trchen1033/VoronMods/btt_tft43_mount/README.md

This is a front skirt 45 deg swival mount for BTT TFT43 touchscreen.

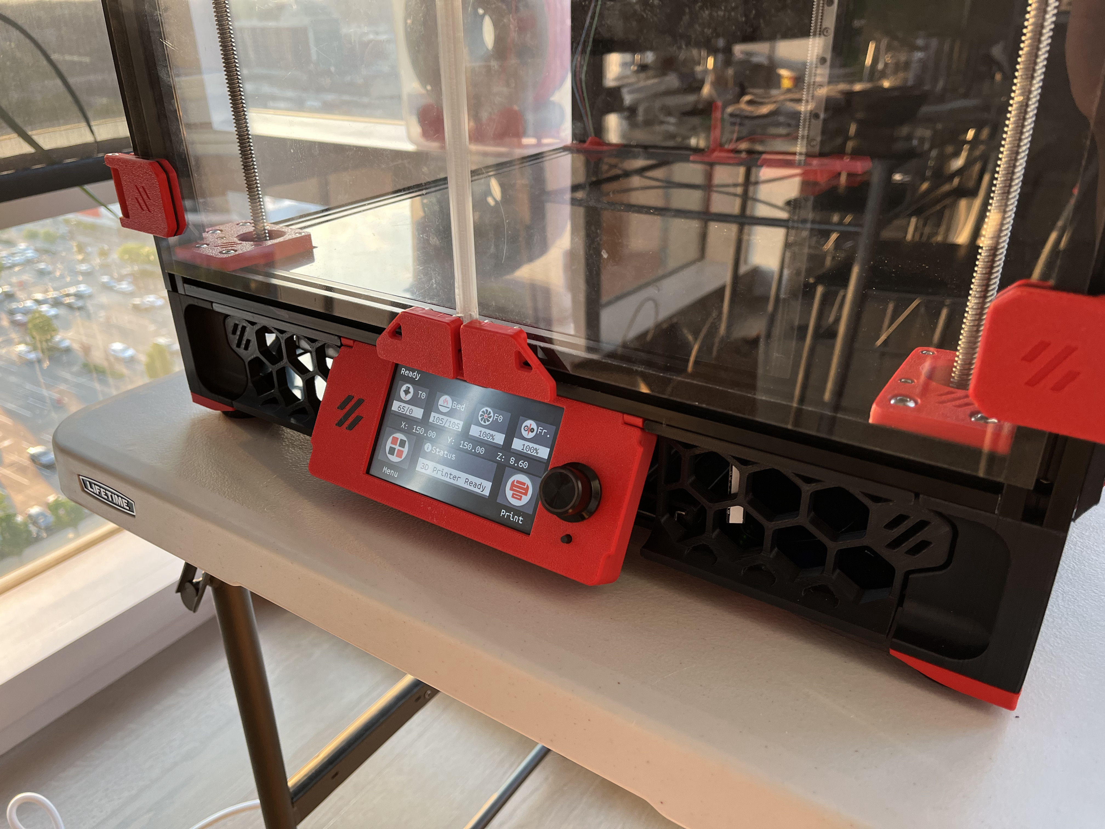
[picture p3: btt_tft43_mount/btt tft43 mount.jpg]
Install Photo


## BOM

- BTT TFT43 touchscreen * 1
- M5x10 BHCS * 1
- M3x8 SHCS * 4
- M3x12 SHCS * 4
- M3x40 SHCS * 1
- M3x5x4 heat-set insert * 7
- 2x25mm shaft (may use 1.75mm filament instead) * 2
- M3 T-nut or hammerhead nut * 2
- M5 T-nut or hammerhead nut * 1
- Narrower front skirt pieces. For 350mm printer uses 300mm skirts,
  300mm printer uses 250mm skirts. You'll have to shrink skirts
  by 25mm yourself if you have a 250mm printer.

## Known Issues

- Only supports touchscreen mode. The EXP1/EXP2 connector for
mini12864 emulation mode is blocked by the swival position block.

- Due to lack of major part dimensions on BTT's CAD file, it is
not designed for proper tolerance. It is a snug fit on mine, but
might not fit yours.

## Installation

1. Install the logo and 4 * M3 heat set insert into the front case.

2. Install 2 * M3 heat set insert into 2 holes in the center of the rear case.

3. Connect the hinges to the front case using the 2mm shafts.
   1.75mm filaments may be used in place of the shafts if not available,
   prefers CF/GF reinforced filaments.

4. Mount the hinges under the extrusion using M3x8 SHCS and T-nut * 2.

5. Sandwich BTT TFT43 between the front case and rear case,
   fasten with M3x12 SHCS * 4.

6. Install M3 heat set insert to the rear brace. This is only used to
   retain the M3x40 SHCS. 

7. Install the rear brace to rear case with M3x8 SHCS * 2.

8. Install the swival position block onto back of the extrusion,
   in between the two arms of the rear brace using M5x10 SHCS and T-nut.

9. Install the M3x40 SHCS to the rear brace, tighten against the
   heat set insert. It does not clamp the arms in any way.
