trchen1033/VoronMods/btt_tft43_mount/src/front_skirt_a_250.stl

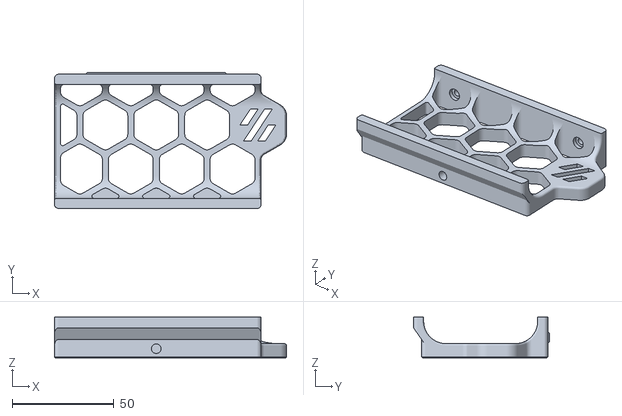
[picture p4: CAD file, 2022-05-22]
btt_tft43_mount/src/front_skirt_a_250.stl
114.0 x 66.8 x 20.0
