trchen1033/VoronMods/btt_tft43_mount/STLs/btt tft43 mount rear_brace.stl

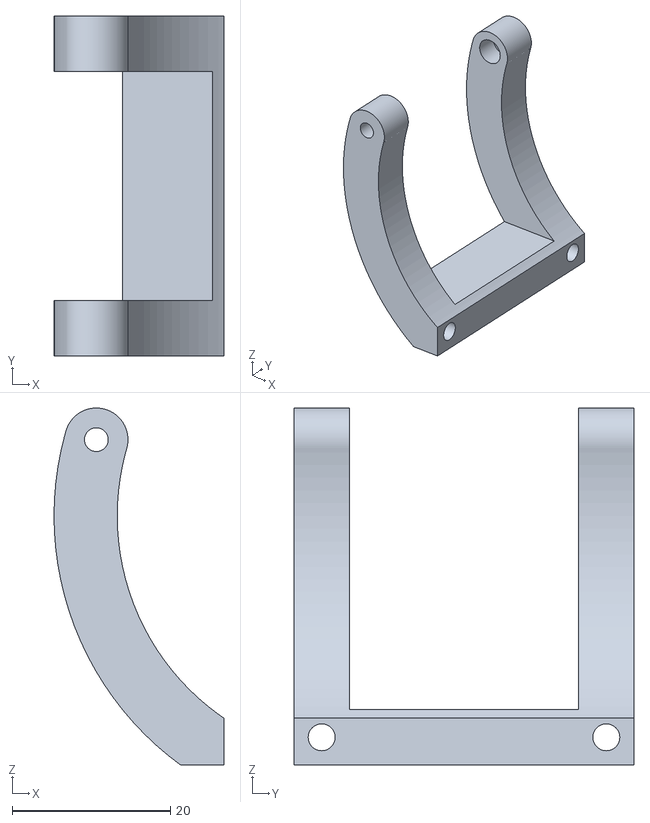
[picture p5: CAD file, 2022-05-22]
btt_tft43_mount/STLs/btt tft43 mount rear_brace.stl
21.5 x 43.0 x 45.1
