trchen1033/VoronMods/mgn7_nutbar/mgn7_nutbar.stl

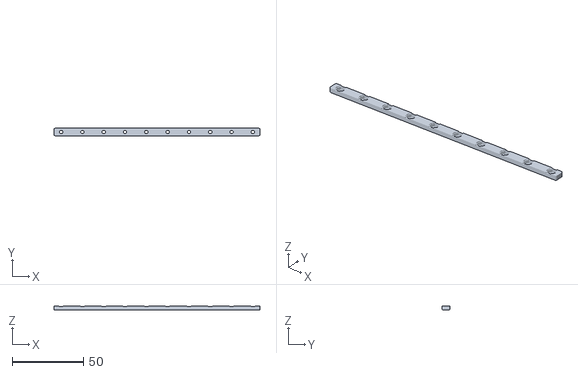
[picture p6: CAD file, 2022-07-07]
mgn7_nutbar/mgn7_nutbar.stl
145.0 x 5.50 x 2.80
