trchen1033/VoronMods/pepe_gasket/pepe gasket.stl

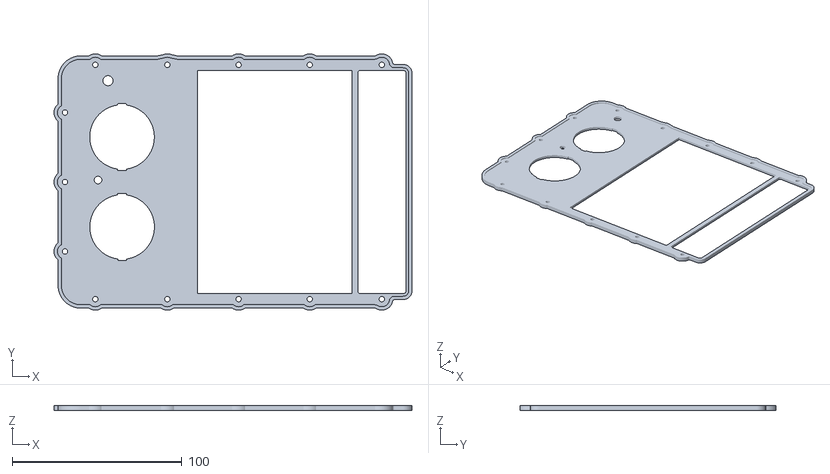
[picture p7: CAD file, 2022-05-08]
pepe_gasket/pepe gasket.stl
211.2 x 151.2 x 3.00
