trchen1033/VoronMods/pepe_gasket/src/pepe housing mask.stl

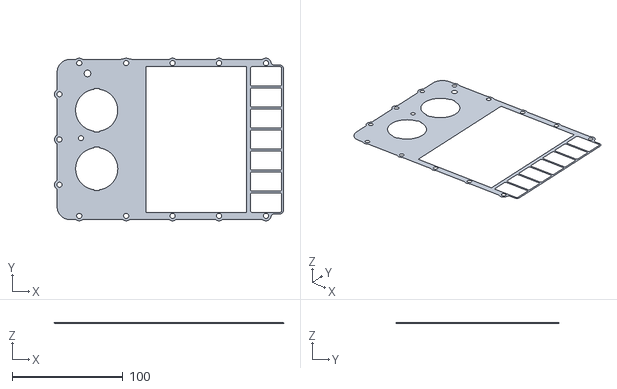
[picture p8: CAD file, 2022-05-08]
pepe_gasket/src/pepe housing mask.stl
207.2 x 147.2 x 0.2
