trchen1033/VoronMods/trizero_mgn5c/STLs/option/Tri-Zero front tensioner GT2 16T.stl

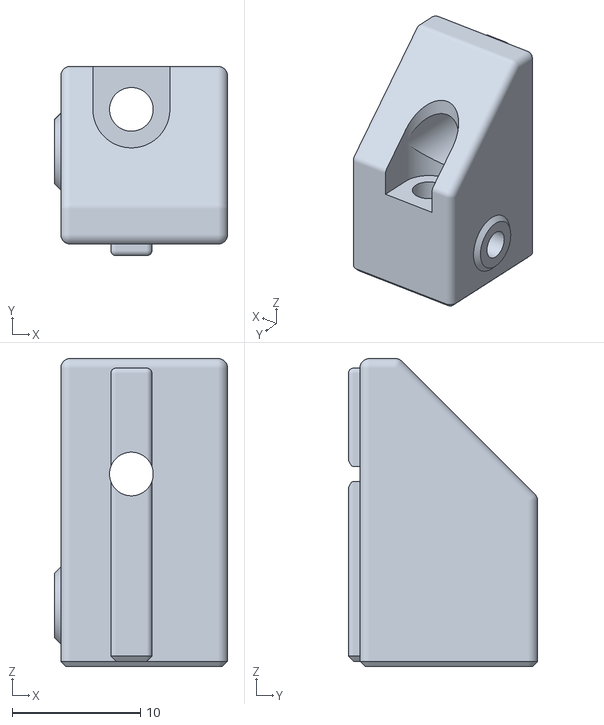
[picture p9: CAD file, 2022-07-30]
trizero_mgn5c/STLs/option/Tri-Zero front tensioner GT2 16T.stl
13.5 x 14.8 x 24.0
