trchen1033/VoronMods/trizero_mgn5c/STLs/Tri-Zero MGN5C bed attachment.stl

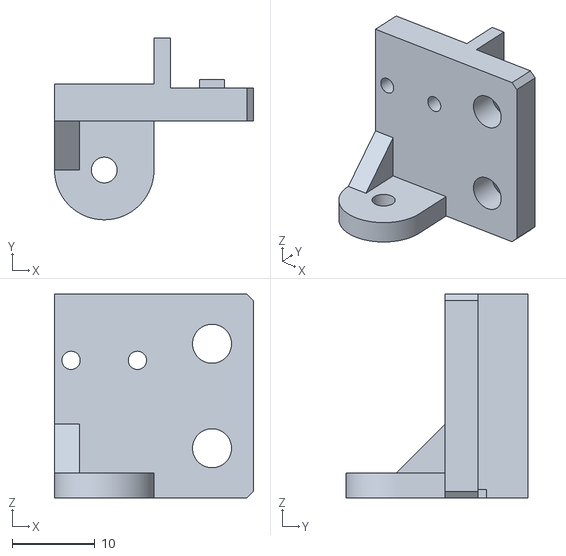
[picture p10: CAD file, 2022-07-30]
trizero_mgn5c/STLs/Tri-Zero MGN5C bed attachment.stl
24.0 x 21.9 x 24.6
