trchen1033/VoronMods/btt_tft43_mount/STLs/btt tft43 mount front_case.stl

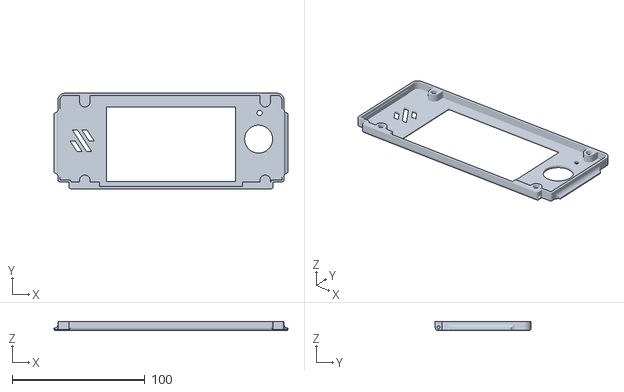
[picture p11: CAD file, 2022-05-22]
btt_tft43_mount/STLs/btt tft43 mount front_case.stl
176.0 x 71.9 x 7.00
