trchen1033/VoronMods/btt_tft43_mount/STLs/btt tft43 mount position_block.stl

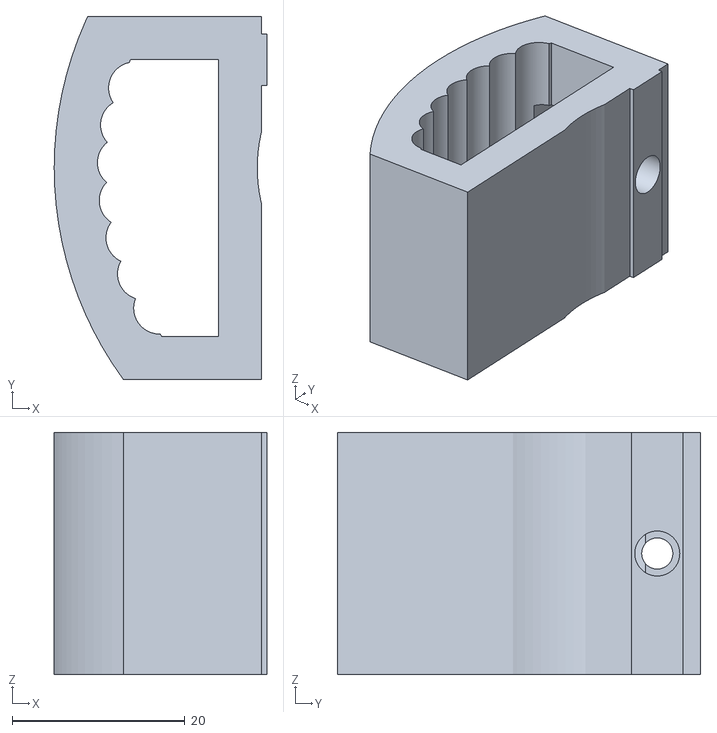
[picture p12: CAD file, 2022-05-22]
btt_tft43_mount/STLs/btt tft43 mount position_block.stl
24.6 x 42.0 x 28.0
