trchen1033/VoronMods/trizero_mgn5c/STLs/Tri-Zero MGN5C belt attachment.stl

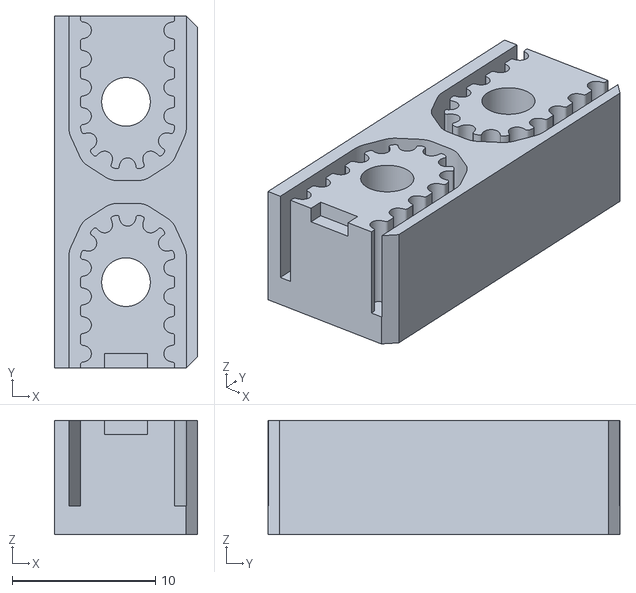
[picture p13: CAD file, 2022-07-25]
trizero_mgn5c/STLs/Tri-Zero MGN5C belt attachment.stl
10.0 x 24.6 x 8.00
