trchen1033/VoronMods/btt_tft43_mount/STLs/btt tft43 mount logo_insert.stl

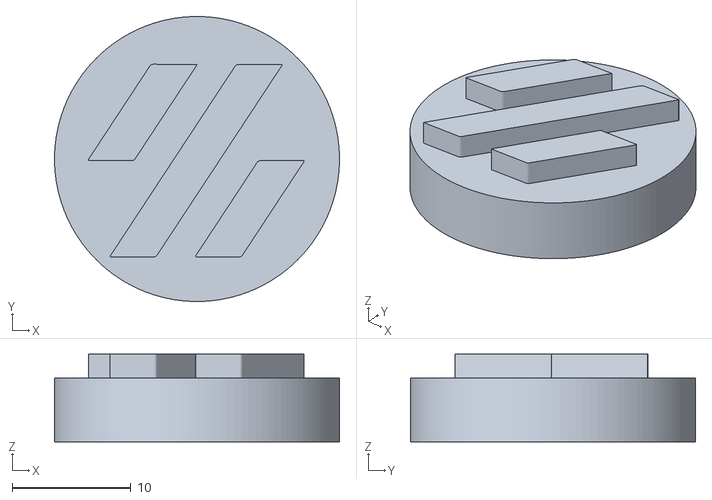
[picture p14: CAD file, 2022-05-22]
btt_tft43_mount/STLs/btt tft43 mount logo_insert.stl
24.0 x 24.0 x 7.40
