trchen1033/VoronMods/btt_tft43_mount/STLs/btt tft43 mount hinge.stl

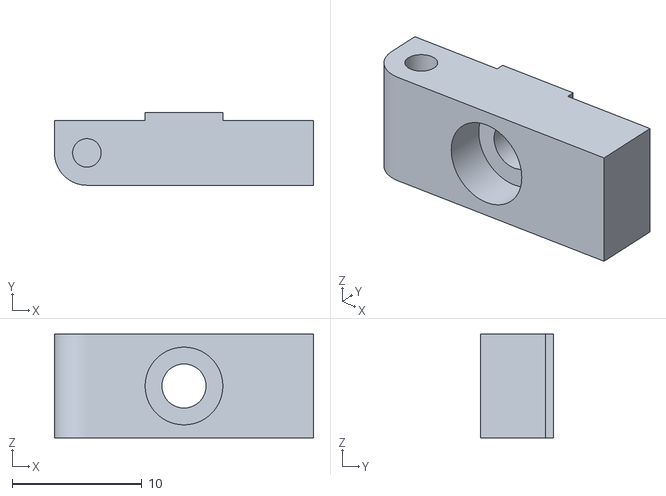
[picture p15: CAD file, 2022-05-22]
btt_tft43_mount/STLs/btt tft43 mount hinge.stl
20.0 x 5.60 x 8.00
