trchen1033/VoronMods/btt_tft43_mount/STLs/btt tft43 mount rear_case.stl

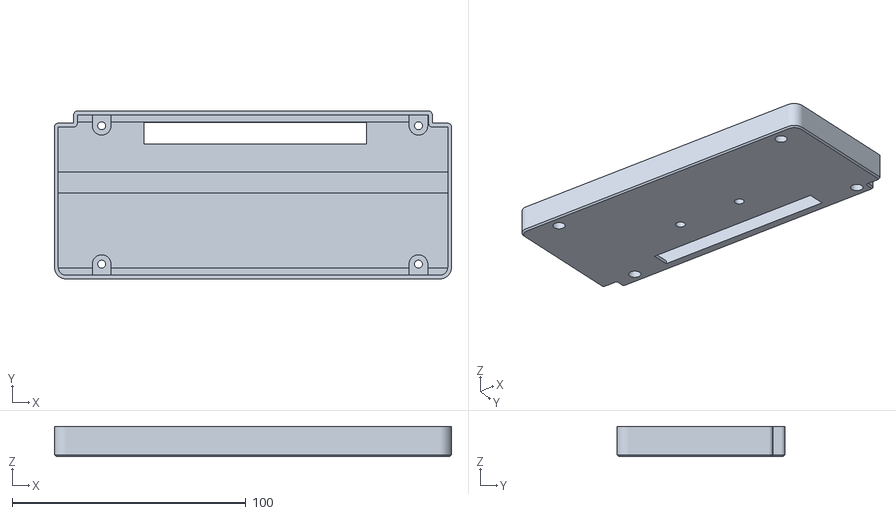
[picture p16: CAD file, 2022-05-22]
btt_tft43_mount/STLs/btt tft43 mount rear_case.stl
170.0 x 71.9 x 13.0
