trchen1033/VoronMods/btt_tft43_mount/src/btt tft43 mount front_case.scad

use <btt tft43 mount.scad>

$fn = 120;
rotate([180,0,0])front_case();
