trchen1033/VoronMods/btt_tft43_mount/src/btt tft43 mount hinge (mirror).scad

use <btt tft43 mount.scad>

$fn = 120;
mirror([1,0,0])hinge();
