trchen1033/VoronMods/btt_tft43_mount/src/btt tft43 mount logo_insert.scad

use <btt tft43 mount.scad>

$fn = 120;
logo_insert();
