trchen1033/VoronMods/btt_tft43_mount/src/btt tft43 mount position_block.scad

use <btt tft43 mount.scad>

$fn = 120;
position_block();
