trchen1033/VoronMods/btt_tft43_mount/src/btt tft43 mount rear_brace.scad

use <btt tft43 mount.scad>

$fn = 120;
rotate([90,0,0])rear_brace();
