trchen1033/VoronMods/trizero_mgn5c/src/Tri-Zero MGN5C bed attachment.scad

use <Tri-Zero MGN5C.scad>

$fn = 120;
rotate([180,0,0])bed_attachment();
