trchen1033/VoronMods/trizero_mgn5c/src/Tri-Zero MGN5C belt attachment.scad

use <Tri-Zero MGN5C.scad>

$fn = 120;
rotate([90, 0, 0])belt_attachment();
