trchen1033/VoronMods/(list of files, cad)

Other CAD files:
btt_tft43_mount/src/front_skirt_b_250.stl
trizero_mgn5c/STLs/Tri-Zero front tensioner F623.stl
btt_tft43_mount/STLs/btt tft43 mount hinge (mirror).stl
trizero_mgn5c/src/Tri-Zero front tensioner GT2 16T.scad
