trchen1033/VoronMods/(commit log)

2022-05-08 Add Pepe Pack gasket
    [pepe gasket.scad, pepe gasket.stl, pepe housing mask.stl]
2022-05-22 Add BTT TFT43 mount
    [btt tft43 mount front_case.scad, btt tft43 mount front_case.stl, btt tft43 mount hinge (mirror).scad, btt tft43 mount hinge (mirror).stl, btt tft43 mount hinge.scad, btt tft43 mount hinge.stl, btt tft43 mount logo_insert.scad, btt tft43 mount logo_insert.stl]
2022-07-07 Add MGN7 nutbar
    [mgn7_nutbar.scad, mgn7_nutbar.stl]
2022-07-25 Add Tri-Zero MGN5C mod
    [GT2 profile.scad, Tri-Zero MGN5C bed attachment.scad, Tri-Zero MGN5C bed attachment.stl, Tri-Zero MGN5C belt attachment.scad, Tri-Zero MGN5C belt attachment.stl, Tri-Zero MGN5C.scad]
2022-07-27 Recall MGN5C mod
    [Tri-Zero MGN5C bed attachment.stl, Tri-Zero MGN5C belt attachment.stl]
2022-07-30 Adding shaved front tensioner for MGN5C mod
    [Tri-Zero MGN5C bed attachment.stl, Tri-Zero MGN5C belt attachment.stl, Tri-Zero MGN5C.scad, Tri-Zero front tensioner F623.scad, Tri-Zero front tensioner F623.stl, Tri-Zero front tensioner GT2 16T.scad, Tri-Zero front tensioner GT2 16T.stl]
